NickMammenga/ExoSkeleton-at-Iowa-State/CircuitBoard/Exo_Silkscreen/Funny-removebg-preview(1).png

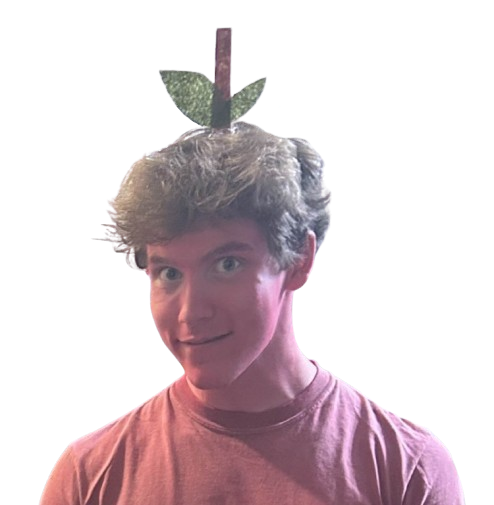
CircuitBoard/Exo_Silkscreen/Funny-removebg-preview(1).png
