NickMammenga/ExoSkeleton-at-Iowa-State/CircuitBoard/Exo_Silkscreen/Funny.jpeg

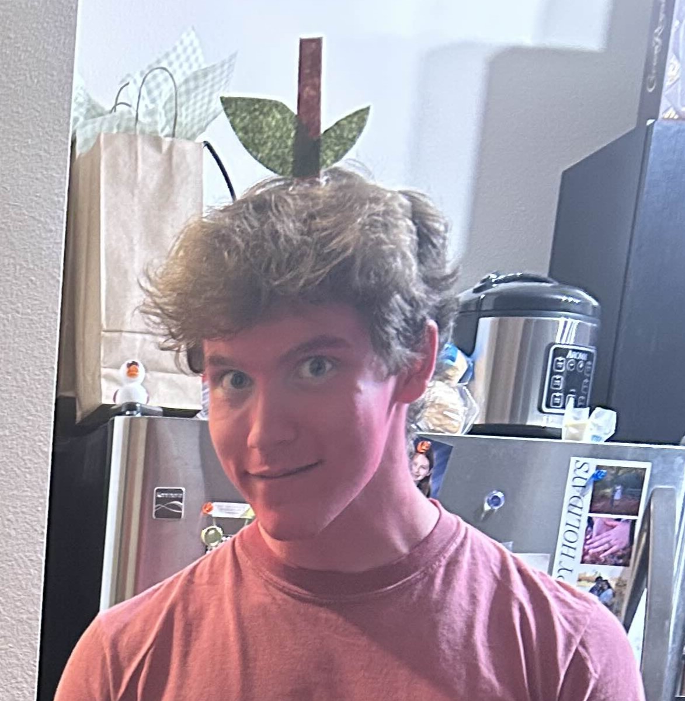
CircuitBoard/Exo_Silkscreen/Funny.jpeg
