NickMammenga/ExoSkeleton-at-Iowa-State/CircuitBoard/Exo_Silkscreen/ExoClubGraphic.png

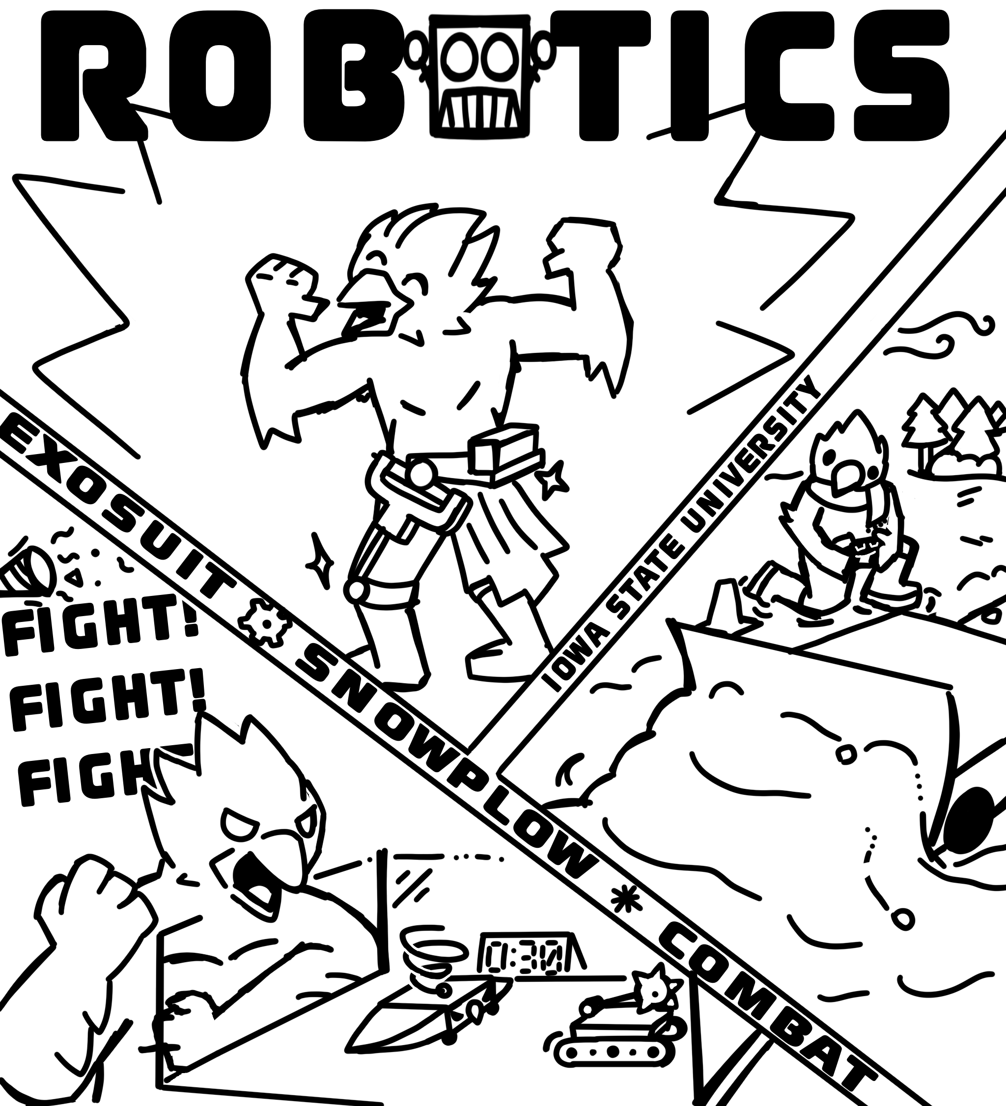
CircuitBoard/Exo_Silkscreen/ExoClubGraphic.png
