NickMammenga/ExoSkeleton-at-Iowa-State/CircuitBoard/Exo_Silkscreen/images.png

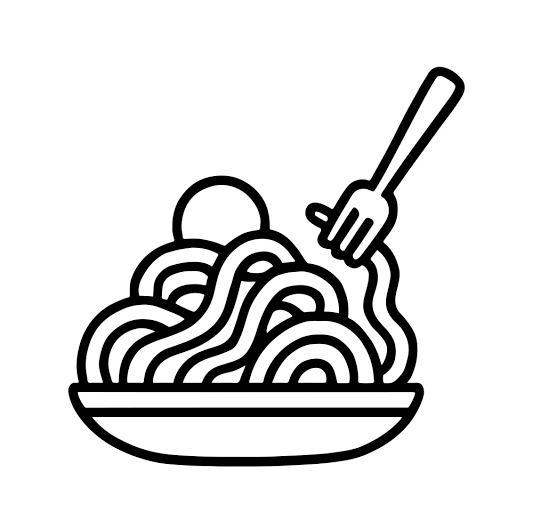
CircuitBoard/Exo_Silkscreen/images.png
