NickMammenga/ExoSkeleton-at-Iowa-State/CircuitBoard/Exo_parts_3D/SMDFuse3D.step

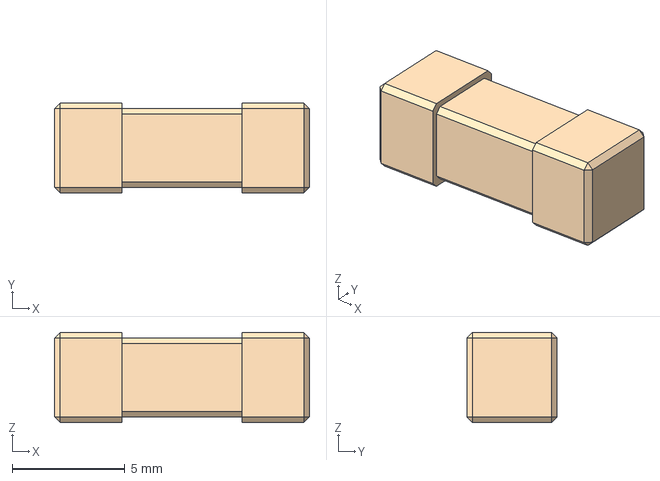
[picture p5: CAD file, 2026-11-11]
CircuitBoard/Exo_parts_3D/SMDFuse3D.step
11.3 x 4.00 x 4.00 mm
