NickMammenga/ExoSkeleton-at-Iowa-State/CircuitBoard/Exo_parts_3D/ESP32 WROOM.step

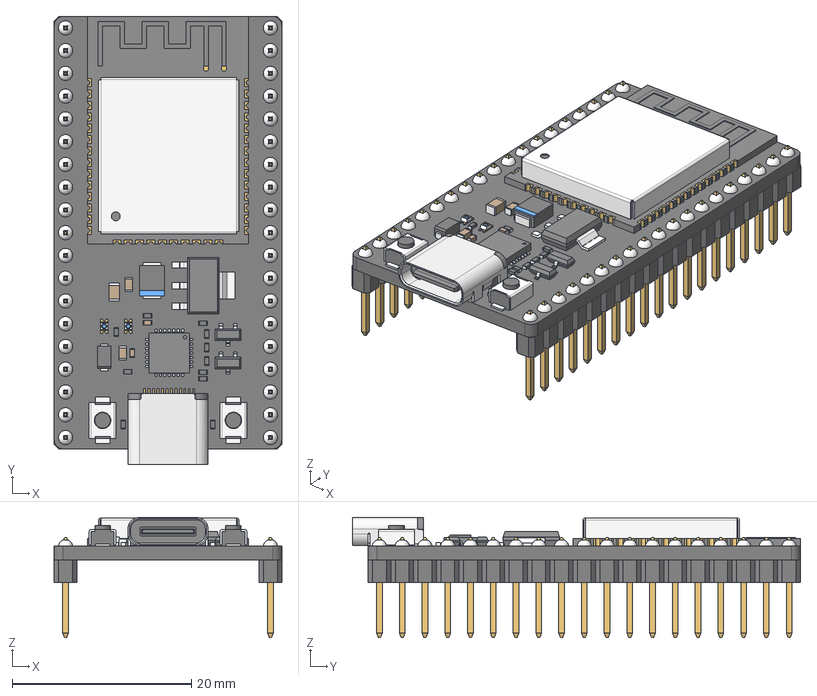
[picture p6: CAD file, 2026-11-11]
CircuitBoard/Exo_parts_3D/ESP32 WROOM.step
25.4 x 50.0 x 13.4 mm
