NickMammenga/ExoSkeleton-at-Iowa-State/CircuitBoard/Exo_parts_3D/RDS3-8S-1065-3-D.step

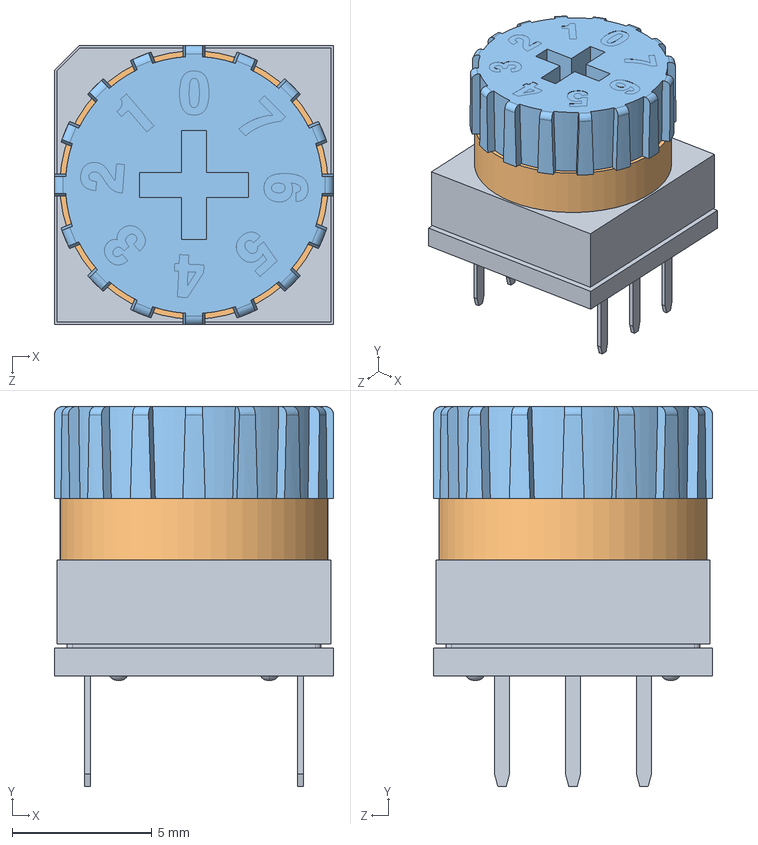
[picture p7: CAD file, 2026-11-11]
CircuitBoard/Exo_parts_3D/RDS3-8S-1065-3-D.step
10.0 x 13.6 x 10.0 mm
RDS3-1065-D HOUSING
RDSV-8-D POSITION
RDS-CAP-3-08
