NickMammenga/ExoSkeleton-at-Iowa-State/CircuitBoard/ExoSkeleton.kicad_pcb

## KiCad design CircuitBoard/ExoSkeleton.kicad_pcb (2026-11-11)

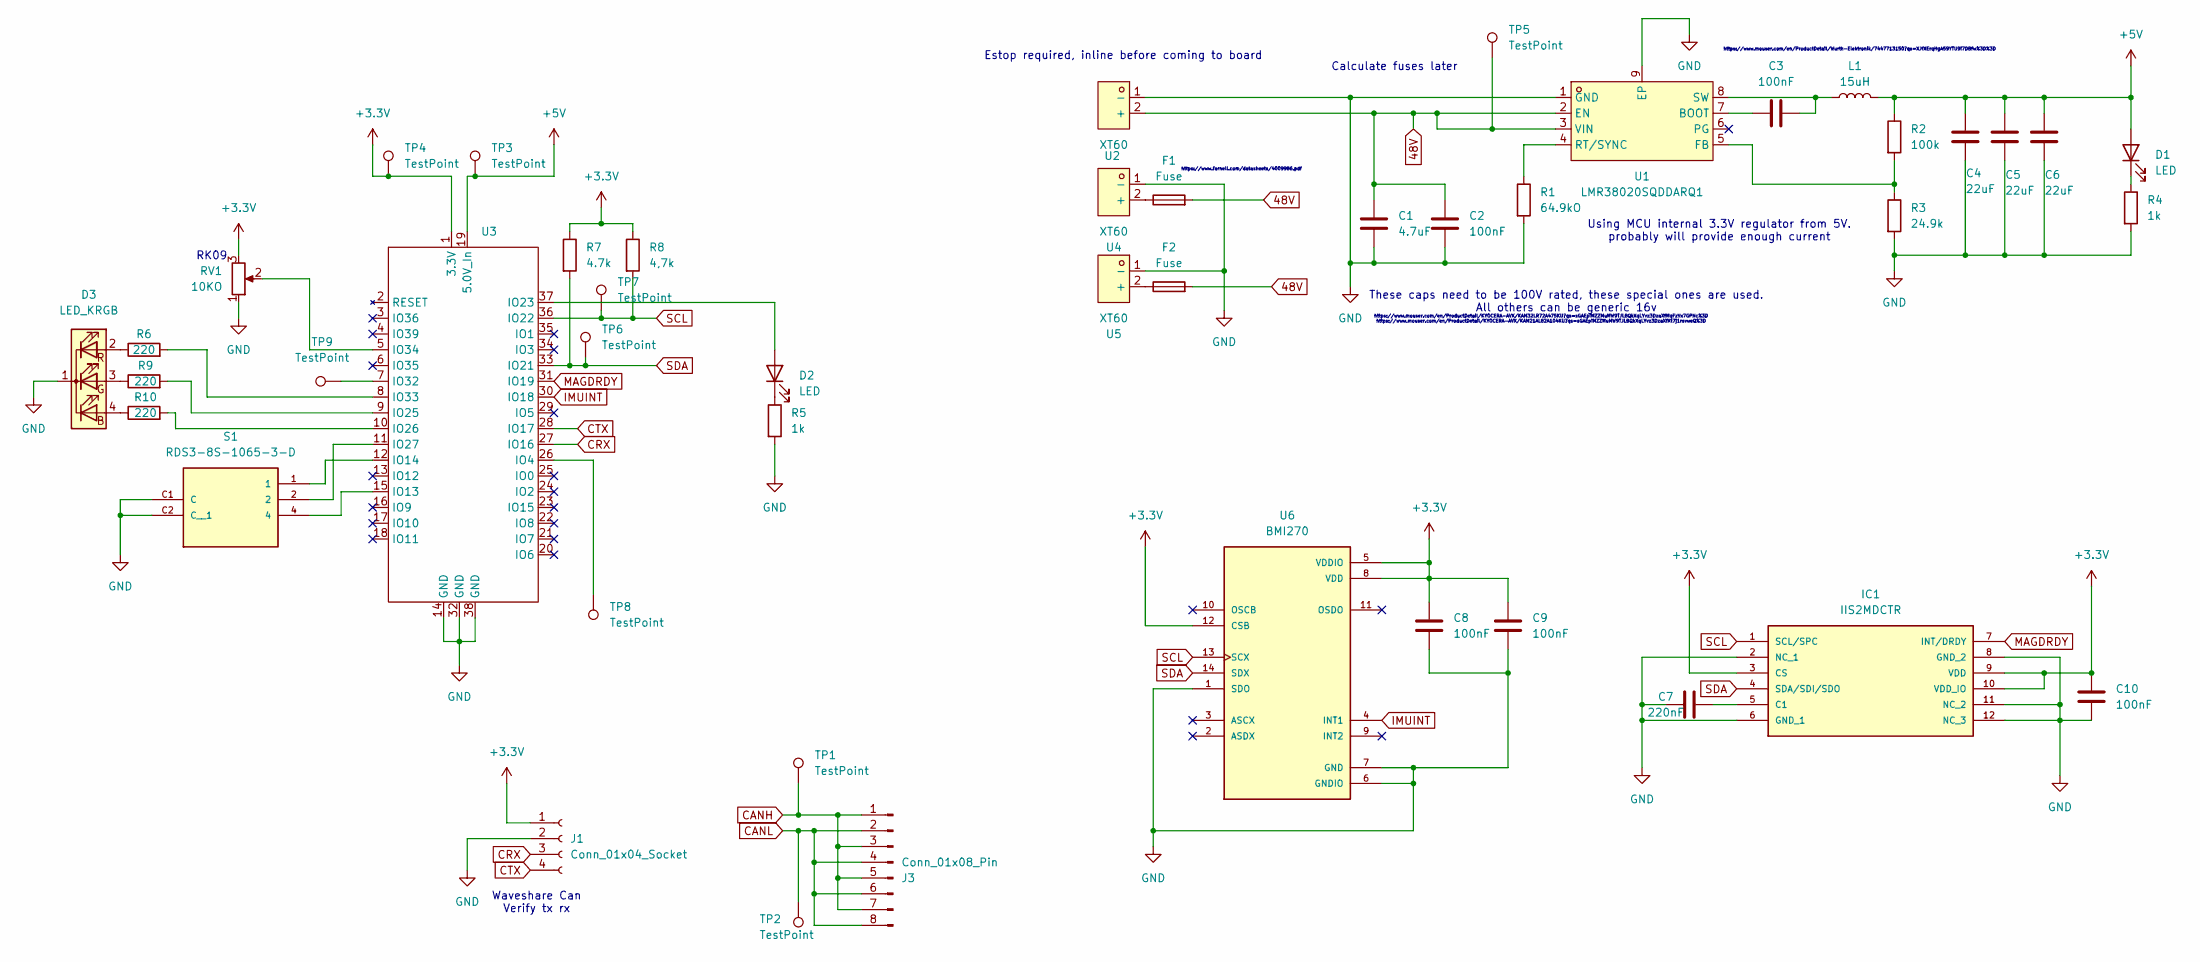
[picture p10: schematic ExoSkeleton.kicad_sch]

Parts:
C1: 4.7uF; C_1210_3225Metric
C2: 100nF; C_0805_2012Metric
C3, C8, C9, C10: 100nF; C_0603_1608Metric
C4, C5, C6: 22uF; C_0603_1608Metric
C7: 220nF; C_0603_1608Metric
D1, D2: LED; LED_0603_1608Metric
D3: LED_KRGB; LED_D5.0mm-4_RGB
F1, F2: Fuse; SMDFuse MP012924
IC1: IIS2MDCTR; MOUSER_PART_NUMBER 511-IIS2MDCTR
J1: Conn_01x04_Socket; PinSocket_1x04_P2.54mm_Horizontal
J3: Conn_01x08_Pin; PinSocket_1x08_P2.54mm_Vertical
L1: 15uH; L_Wuerth_HCI-1030
R1: 64.9kO; R_0603_1608Metric
R2: 100k; R_0603_1608Metric
R3: 24.9k; R_0603_1608Metric
R4, R5: 1k; R_0603_1608Metric
R6, R9, R10: 220; R_0603_1608Metric
R7: 4.7k; R_0603_1608Metric
R8: 4,7k; R_0603_1608Metric
RV1: 10KO; Potentiometer_Alps_RK09K_Single_Vertical
S1: RDS3-8S-1065-3-D; SW_RDS3-8S-1065-3-D; MPN RDS3-8S-1065-3-D
TP1, TP2, TP3, TP4, TP5, TP6, TP7, TP8, TP9: TestPoint; TestPoint_Pad_D2.0mm
U1: LMR38020SQDDARQ1; SOIC-8_L4.9-W3.9-P1.27-LS6.0-BL-EP3.4; MPN LMR38020SQDDARQ1; LCSC Part C18212861
U2, U4, U5: XT60; AMASS_XT60PW-M_1x02_P7.20mm_Horizontal; MPN XT60-M.; LCSC Part C98733
U3: ESP32 38Pin Slim
U6: BMI270; XDCR_BMI270

Connections:
48V: C1.1, C2.1, F1.2, F2.2, TP5.1 (1_1), U1.2 (EN), U1.3 (VIN), U2.2 (+)
+3.3V: C8.1, C9.1, C10.1, IC1.3 (CS), IC1.9 (VDD), IC1.10 (VDD_IO), J1.1, R7.1, R8.1, RV1.3, TP4.1 (1_1), U3.1 (3.3V), U6.5 (VDDIO), U6.8 (VDD), U6.12 (CSB)
+5V: C4.1, C5.1, C6.1, D1.2 (A), L1.2, R2.1, TP3.1 (1_1), U3.19 (5.0V_In)
CANH: J3.1, J3.3, J3.5, J3.7, TP1.1 (1_1)
CANL: J3.2, J3.4, J3.6, J3.8, TP2.1 (1_1)
CRX: J1.3, U3.27 (IO16)
CTX: J1.4, U3.28 (IO17)
GND: C1.2, C2.2, C4.2, C5.2, C6.2, C7.1, C8.2, C9.2, C10.2, D3.1 (K), IC1.2 (NC_1), IC1.6 (GND_1), IC1.8 (GND_2), IC1.11 (NC_2), IC1.12 (NC_3), J1.2, R1.2, R3.2, R4.2, R5.2, RV1.1, S1.C1 (C), S1.C2 (C__1), U1.1 (GND), U1.9 (EP), U2.1 (-), U3.14 (GND), U3.32 (GND), U3.38 (GND), U4.1 (-), U5.1 (-), U6.1 (SDO), U6.6 (GNDIO), U6.7 (GND)
IMUINT: U3.30 (IO18), U6.4 (INT1)
MAGDRDY: IC1.7 (INT/DRDY), U3.31 (IO19)
unnamed: D1.1 (K), R4.1
unnamed: D2.2 (A), U3.37 (IO23)
unnamed: D2.1 (K), R5.1
unnamed: D3.4 (BA), R10.1
unnamed: D3.3 (GA), R9.1
unnamed: D3.2 (RA), R6.1
unnamed: C7.2, IC1.5 (C1)
unnamed: C3.1, U1.7 (BOOT)
unnamed: R2.2, R3.1, U1.5 (FB)
unnamed: R1.1, U1.4 (RT/SYNC)
unnamed: C3.2, L1.1, U1.8 (SW)
unnamed: TP8.1 (1_1), U3.26 (IO4)
unnamed: S1.4, U3.15 (IO13)
unnamed: S1.1, U3.12 (IO14)
unnamed: R9.2, U3.9 (IO25)
unnamed: R10.2, U3.10 (IO26)
unnamed: S1.2, U3.11 (IO27)
unnamed: TP9.1 (1_1), U3.7 (IO32)
unnamed: R6.2, U3.8 (IO33)
unnamed: RV1.2, U3.5 (IO34)
unnamed: F1.1, U4.2 (+)
unnamed: F2.1, U5.2 (+)
SCL: IC1.1 (SCL/SPC), R8.2, TP7.1 (1_1), U3.36 (IO22), U6.13 (SCX)
SDA: IC1.4 (SDA/SDI/SDO), R7.2, TP6.1 (1_1), U3.33 (IO21), U6.14 (SDX)

Notes on the sheet:
Calculate fuses later
These caps need to be 100V rated, these special ones are used. All others can be generic 16v
https://www.mouser.com/en/ProductDetail/Wurth-Elektronik/7447713150?qs=XJfXErqHgA59YTU9i7DBfw%3D%3D
https://www.mouser.com/en/ProductDetail/KYOCERA-AVX/KAM32LR72A475KU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 https://www.mouser.com/en/ProductDetail/KYOCERA-AVX/KAM21AL82A104KU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
Using MCU internal 3.3V regulator from 5V. probably will provide enough current
Waveshare Can Verify tx rx
https://www.farnell.com/datasheets/4009986.pdf
RK09
Estop required, inline before coming to board

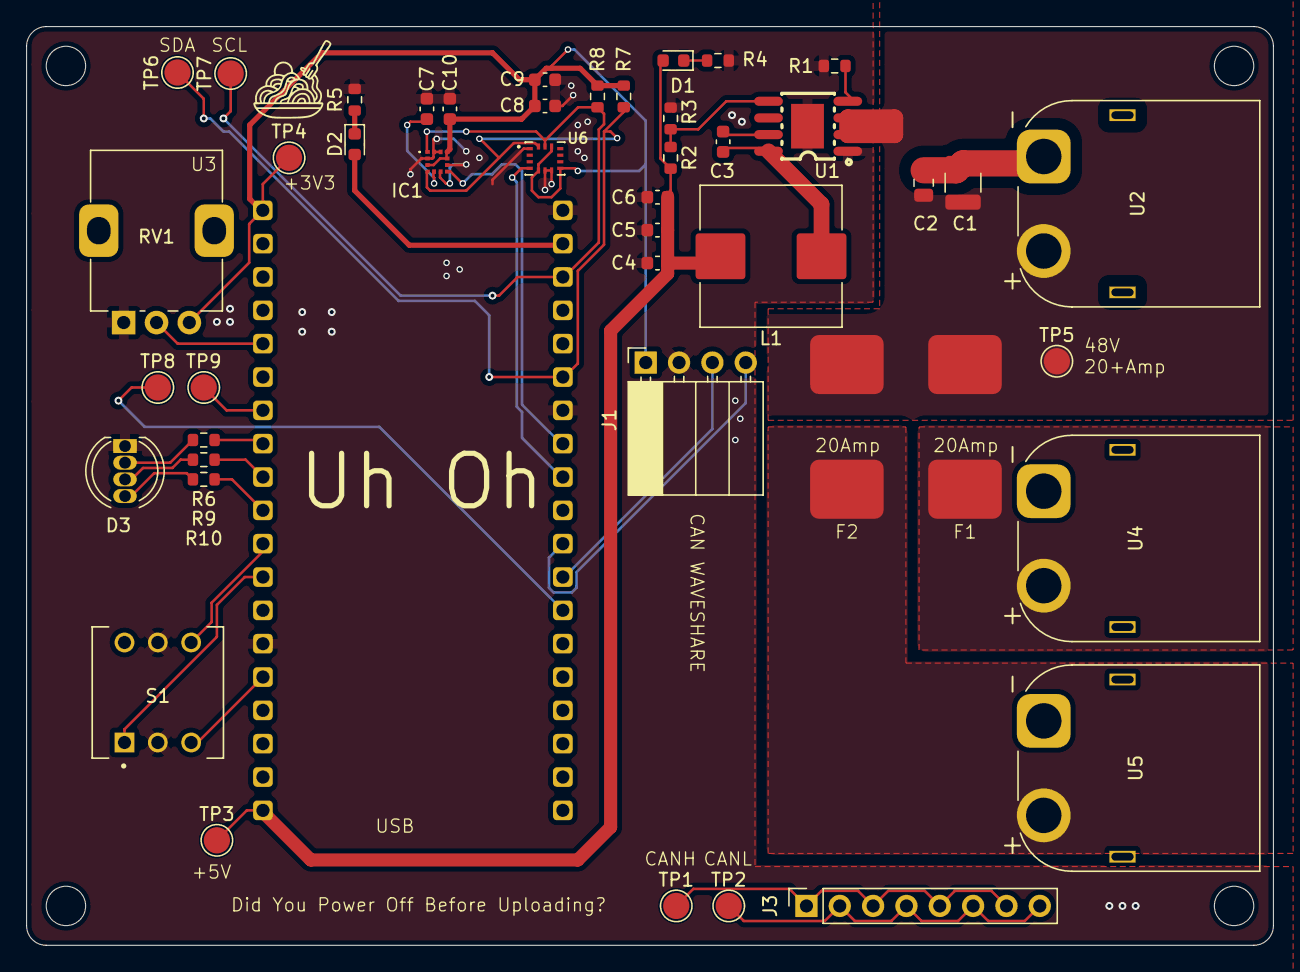
[picture p11: board ExoSkeleton.kicad_pcb from above]

Board: 2 copper layers, 95.0 x 70.0 mm, 46 parts (0 on the bottom side), 34 nets.
